13022591351/KicadLib/(commit log)

2023-07-18 初次提交
    [430450612.stp, 430452212.stp, 430452412.stp, 5009010801.stp, 5177983-1.stp, 5177983-2.stp, 5177984-1.stp, 5177984-2.stp]
2023-08-03 修改了UAC连接器封装，增加了ESP封装
    [Switch_3X4X2.stp, UAC16-8.stp, UAC16-9.stp, UAC20-5.stp, UAC28-2.stp]
2023-08-10 新增Amass连接器封装
    [XT30_2+2_PB-M.stp, XT30_2+2_PW-M.stp]
2023-09-25 国庆前的同步
    [28.110.stp, DFN-6_2x2mm_MOS.stp, DFN-8-1EP_4x4.5mm_P0.8mm_EP2.6x3.6mm.stp, DFN-8_3x3mm_MOS.stp, DRV8316R.stp, D_SOT_886.stp, J30J-37TJW.stp, J30J-51ZKW.stp]
2024-02-08 年前更新
    [Hirose_FH12-30S-0.5SH_1x30-1MP_P0.50mm_Horizontal.stp, LFCSP-20-1EP_4x4mm_P0.5mm_EP2.5x2.5mm.stp, QFN-56-1EP_8x8mm_P0.5mm_EP5.9x5.9mm.stp, SGDBF-05-018P-H22.stp, SGDBM-05-018P-H08.stp, STSPIN32F0.stp, UP9636PQMY.stp, VQFN-HR-12.stp]
2025-09-30 新建及完善部分器件
    [2016450360.stp, 2016450380.stp, 2016450400.stp, 2035672007.stp, 2035673007.stp, 2035674007.stp, 55959-1030.stp, 55959-2030.stp]
2026-01-25 新增部分封装
    [DFN-83x3mm_Dual_MOS.stp, LFCSP-40-1EP_6x6mm_P0.5mm_EP4.6x4.6mm.stp, LGA-12_4x5mm.stp, LGA-18.stp, Mounting_M2x4x0.3_L1.5.stp, Onsemi_DualCool-8_8x8mm.stp, PG-HSOF-8-1_MOS.stp, QFN-100-1EP_12x12mm_P0.4mm_EP6.2x6.2mm.stp]
2026-08-26 做图框模板前的封装更新
    [AUAV-RR.stp, CP_EIA-7561-62_TORCH-H.stp, DFN-8_3x3mm_Dual_MOS.stp, EM50x_Conn.stp, FH12-20S-0.5SH_1x20-1MP_P0.50mm_Horizontal.stp, FH12-22S-0.5SH_1x22-1MP_P0.50mm_Horizontal.stp, FH12-30S-0.5SH_1x30-1MP_P0.50mm_Horizontal.stp, FH12-6S-0.5SH_1x06-1MP_P0.50mm_Horizontal.stp]
2026-08-26 变更目录命名规范
2026-08-26 添加kicad 10库加载规则支持
2026-08-27 增加工程模板
    [TXZK-STD-Project.kicad_pcb, TXZK-STD-Project.kicad_sch]
2026-09-05 更新部分封装和模板
    [TXZK-STD-Project.kicad_pcb, TXZK-STD-Project.kicad_sch]
2026-09-05 添加新的封装并完善工程模板
    [TXZK-STD-Project.kicad_pcb, TXZK-STD-Project.kicad_sch]
2026-09-05 新增Export-Toolkit一键导出插件
2026-09-05 分离铺铜和导出逻辑
2026-09-05 增强插件可视化
2026-09-07 修正模板
    [TXZK-STD-Project.kicad_pcb, TXZK-STD-Project.kicad_sch]
2026-09-13 更形部分封装
2026-09-18 更新封装、图框、导出插件
2026-09-19 规范库命名与封装模型，更新图框和 PDF 导出
2026-09-24 更新部分封装和插件
